SMDVIBE/ESP32-2SC5200-Transistor-Heater/(list of files, drawings)

Other design files:
Hardware/EasyEDA/Schematic_ESP32-Transistor-Temperature-Controller.json
